buming68/sigamp/README.md

# sigamp
 small RF signal process
 main branch 版本Ver1.0X     无场强LED显示功能，有usart1串口调试功能
 branch-2LED-off  版本1.0B   有场强LED显示功能，双LED兼容输出，其中一个输出用到串口1引脚，所以无usart1串口调试功能
