buming68/sigamp/DOCUMENT/自研移动电视覆盖补点DTV选频处理板测试   2023-04-19.pdf

自研移动电视覆盖补点 DTV 选频处理板测试

### 陆建华 2023-04-19 一、 SDK2712 编调一体机信号源测试

### 1、最小接收门限： -65.7dBm

E8000 频谱仪测试数据 | DS7000 测试数据

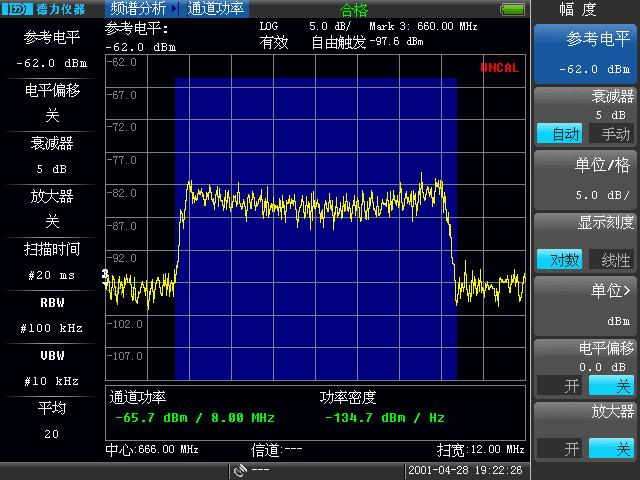
[picture p1: figure]
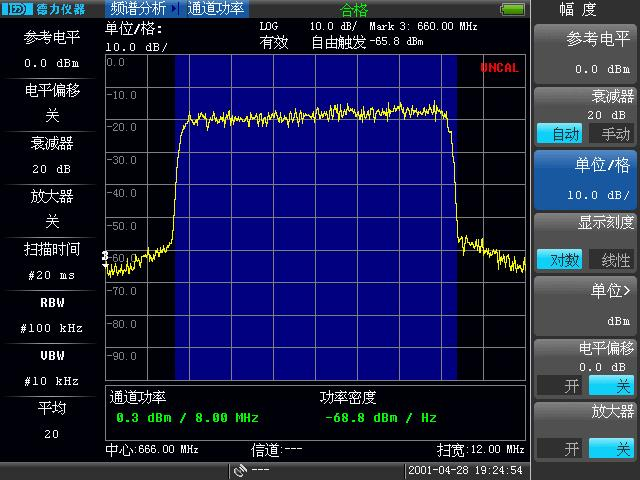
[picture p2: figure]

2、选频处理板输出：0.3dBm

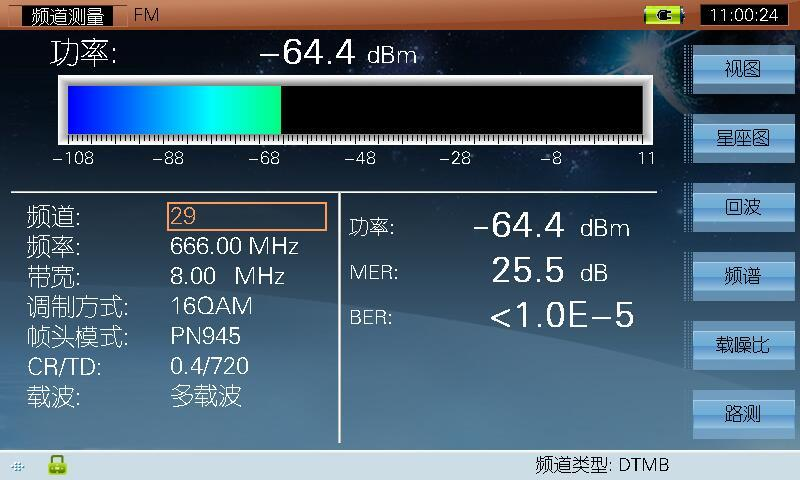
[picture p3: figure]
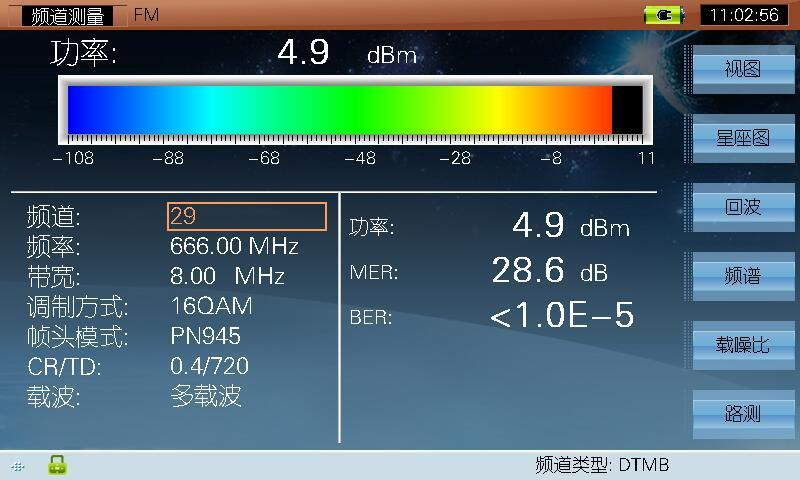
[picture p4: figure]

E8000 频谱仪测试数据 | DS7000 测试数据
| 输入不加衰减器测试

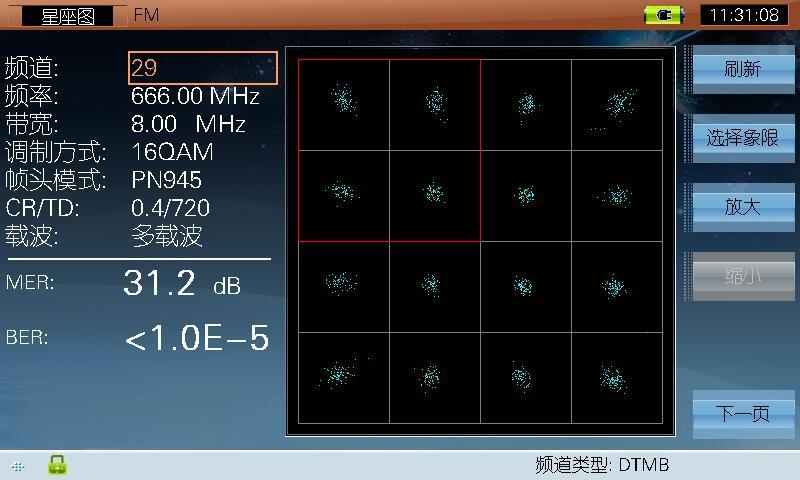
[picture p5: figure]
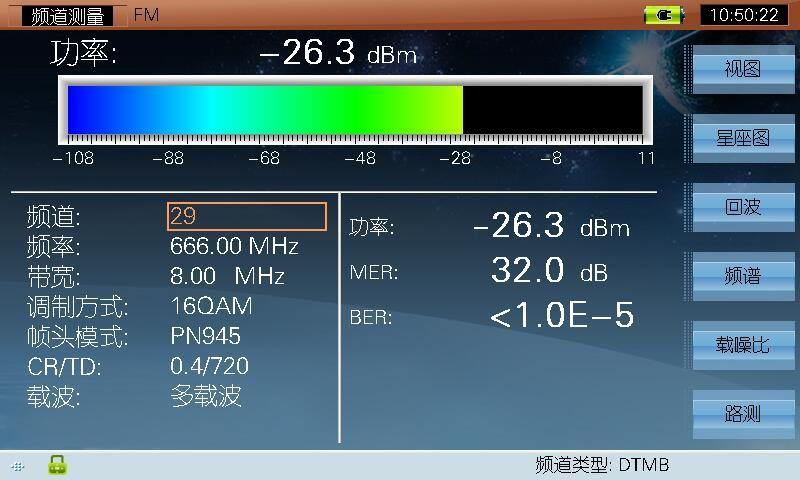
[picture p6: figure]

DS7000 测试的输出信号星族图 | 输入加 30dB 衰减器测试

二、 DS32 频道空收信号测试

1、广电传媒大厦室内接收： -65.7dBm

E8000 频谱仪测试数据 | DS7000 测试数据

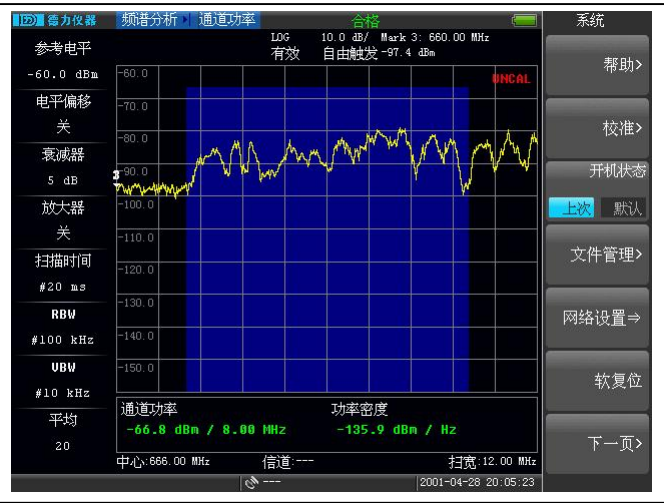
[picture p7: figure]
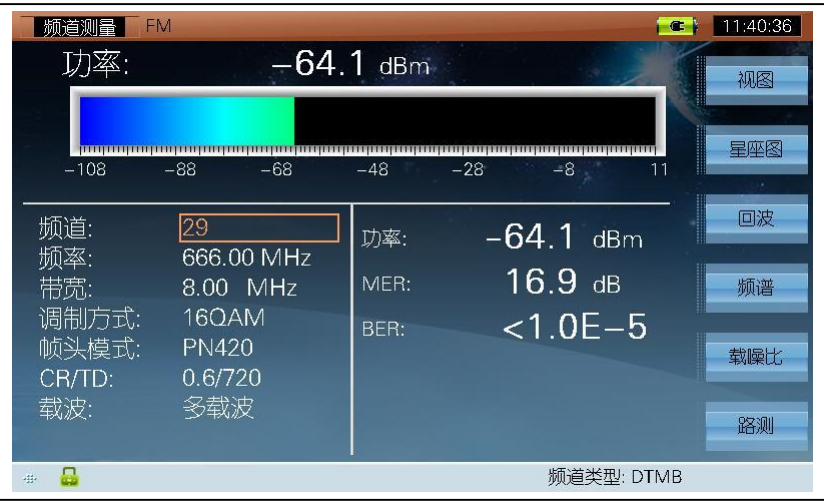
[picture p8: figure]

2、选频处理板输出：-0.1dBm

E8000 频谱仪测试数据 | DS7000 测试数据
| 输入不加衰减器测试

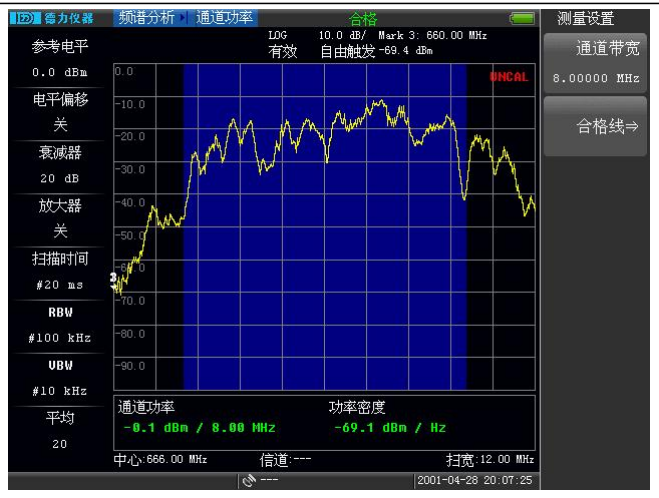
[picture p9: figure]
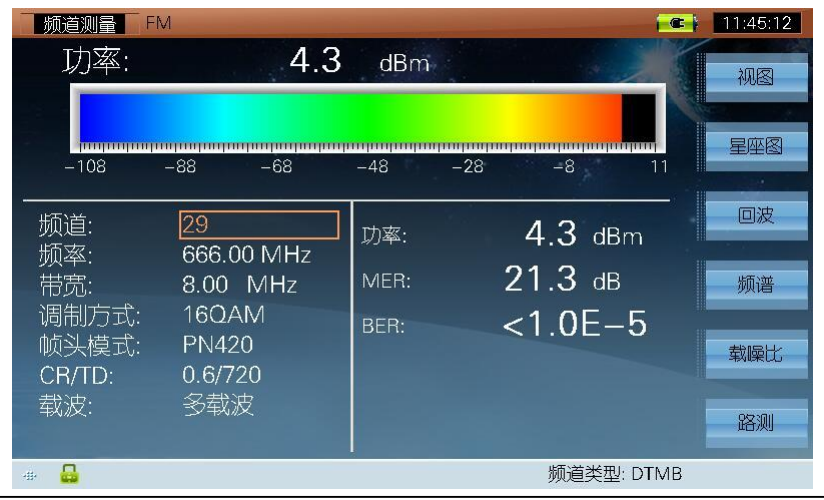
[picture p10: figure]

DS7000 解调图像 | 输入加 30dB 衰减器测试

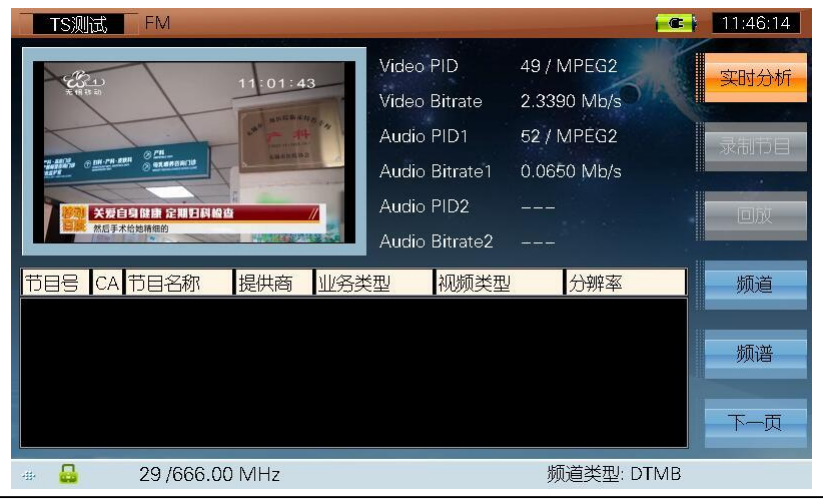
[picture p11: figure]
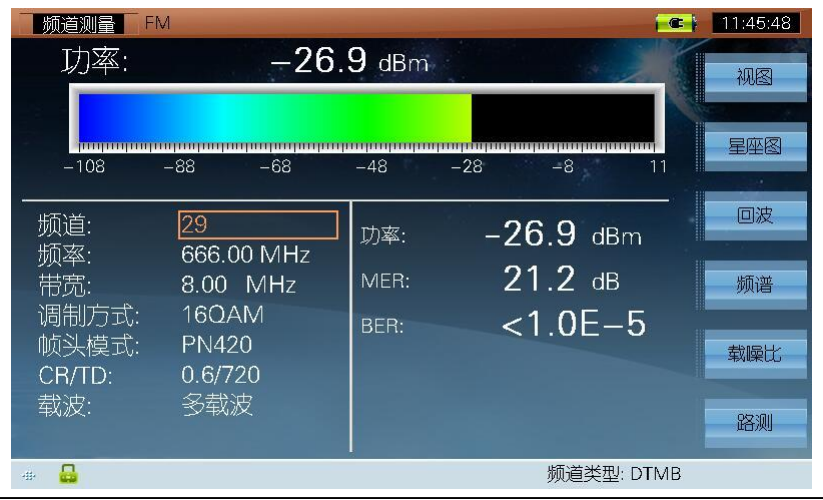
[picture p12: figure]

自研 DTV 选频处理板接收门限设计为-65dBm，原三维产品为

-44dBm，接收门限改善了 20dB 以上。

### —End—
