buming68/sigamp/DOCUMENT/自研DTV小信号选频单元原理图 终稿 2023-04-28.pdf

BOOT1=X | BOOT0=0 主闪存储器启动
BOOT1=0 | BOOT0=1 系统存储器启动

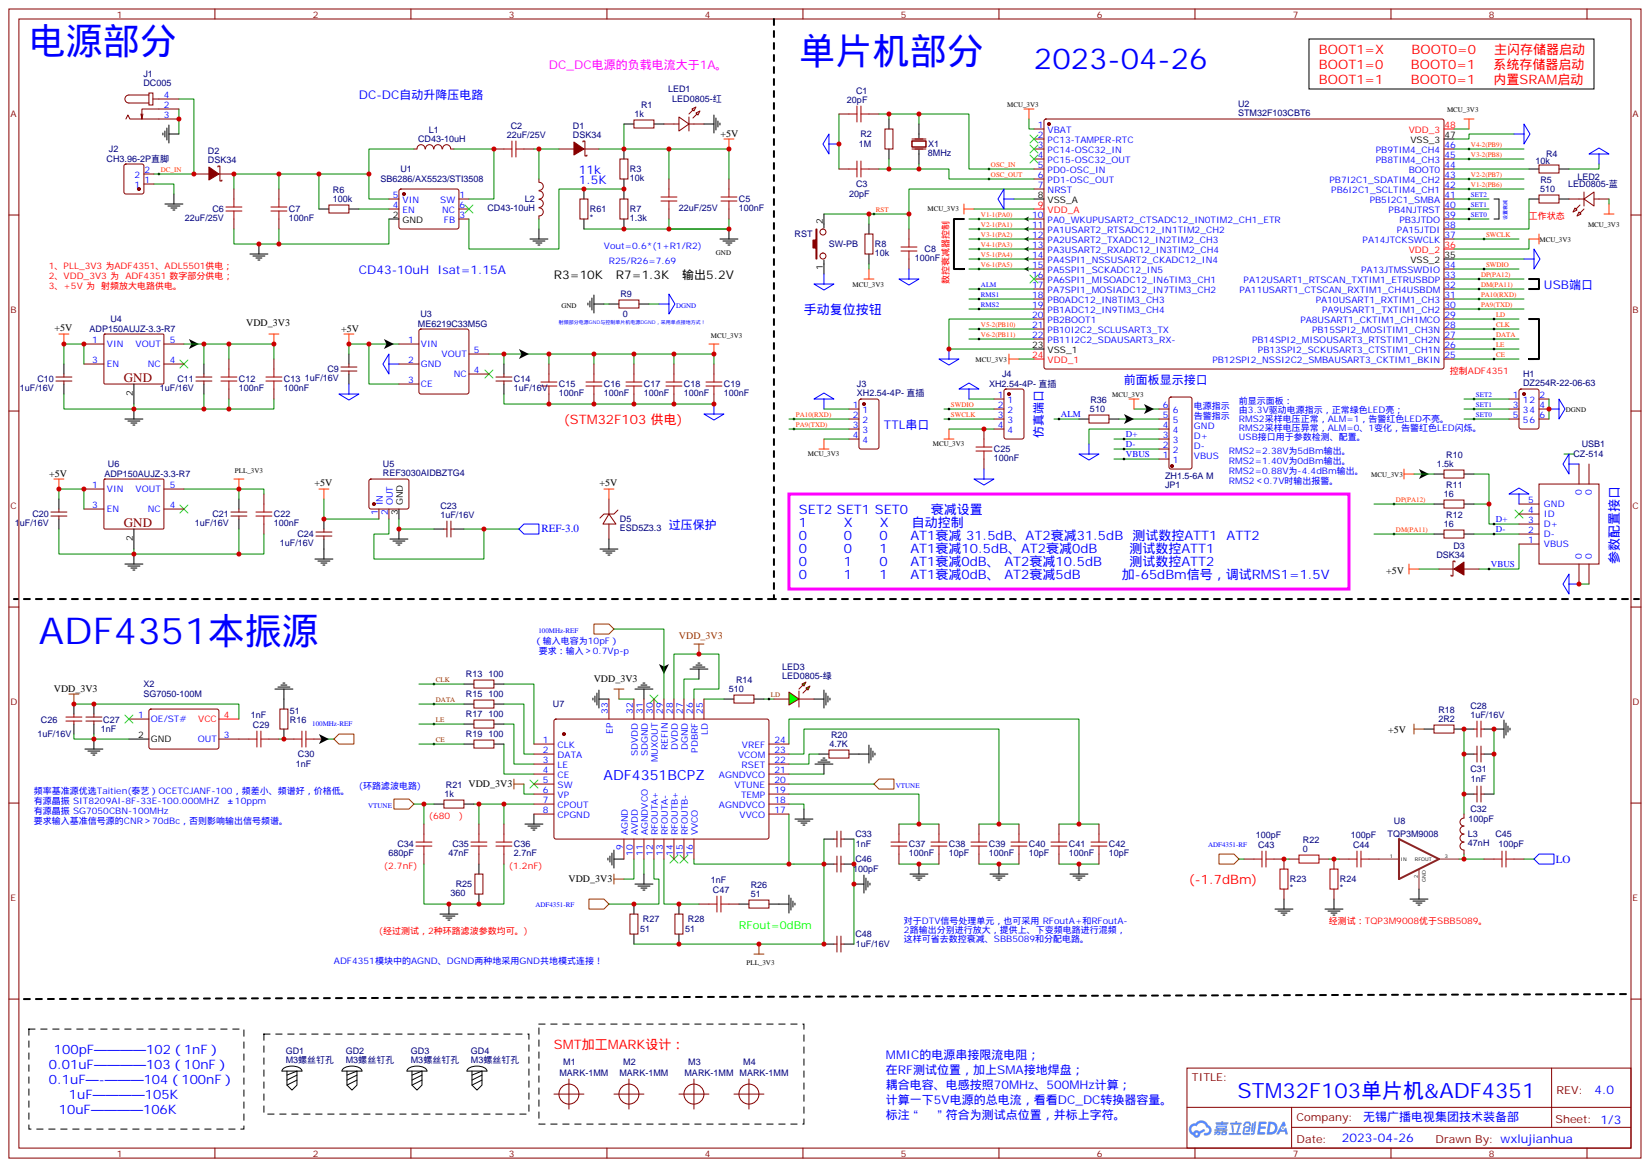
[picture p13: page 1]

LD 25 PDBRF 26 DGND 27 DVDD 28 REFIN 29 MUXOUT 30 SDGND 31 SDVDD 32

VVCO 17 AGNDVCO 18 TEMP 19 VTUNE 20 AGNDVCO 21 RSET 22 VCOM 23 VREF 24

频率基准源优选Taitien(泰艺）OCETCJANF-100，频差小、频谱好，价格低。
有源晶振 SG7050CBN-100MHz
要求输入基准信号源的CNR＞70dBc，否则影响输出信号频谱。

对于DTV信号处理单元，也可采用 RFoutA+和RFoutA-
2路输出分别进行放大，提供上、下变频电路进行混频，
这样可省去数控衰减、SBB5089和分配电路。

# DTV小信号选频单元电路原理图【ok】

## RF 666MHz

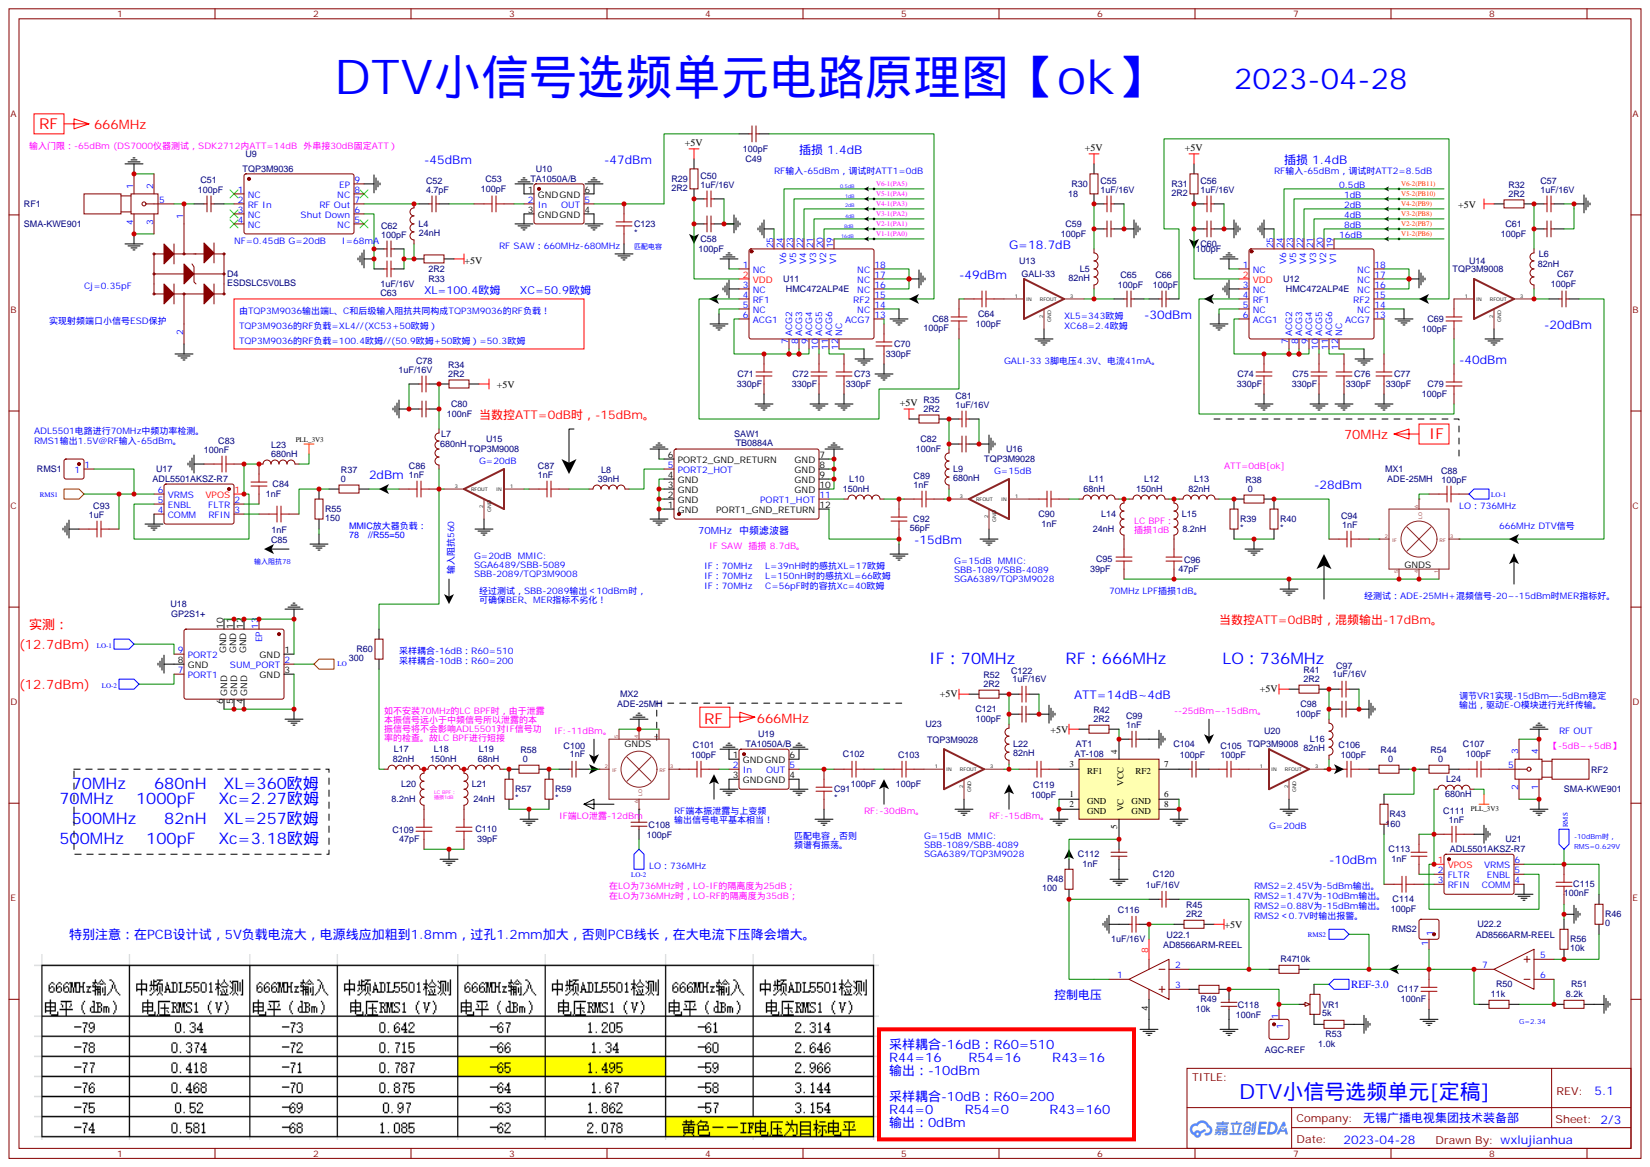
[picture p14: page 2]

ACG7 13 NC 14 RF2 15 NC 16 NC 17 NC 18

特别注意：在PCB设计试，5V负载电流大，电源线应加粗到1.8mm，过孔1.2mm加大，否则PCB线长，在大电流下压降会增大。

# DTV选频处理单元IF功率检测、数控衰减量配置

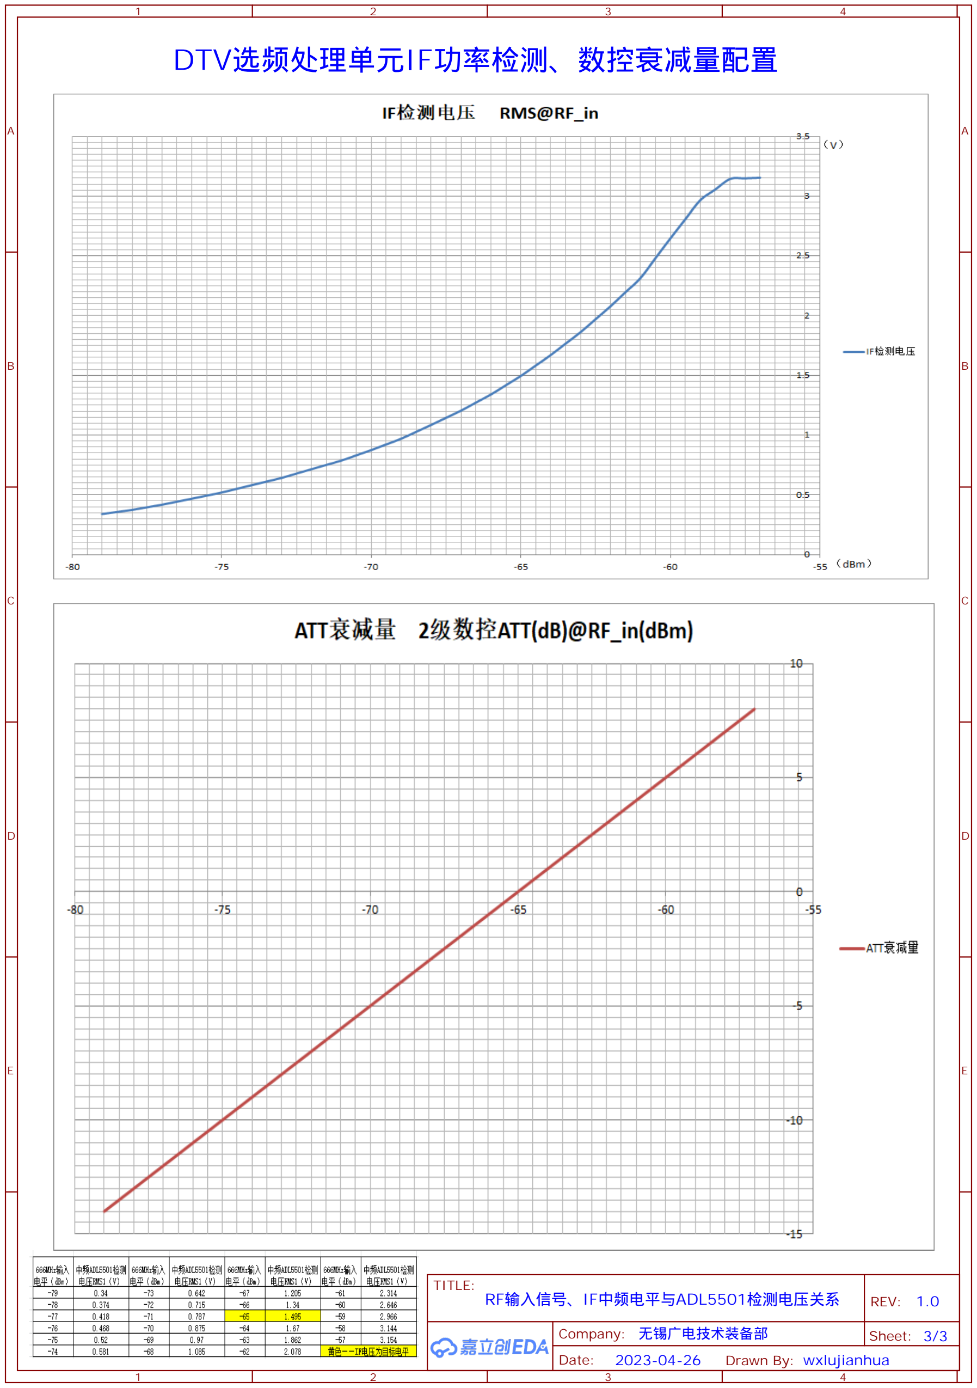
[picture p15: page 3]

A | A
B | B
C | C
D | D
E | E
RF输入信号、IF中频电平与ADL5501检测电压关系 | REV: 1.0

Company: 无锡广电技术装备部
