buming68/sigamp/Core/Inc/main.h

#define LED1_Pin GPIO_PIN_13
#define LED1_GPIO_Port GPIOC
#define HMC0_Pin GPIO_PIN_0
#define HMC0_GPIO_Port GPIOA
#define HMC1_Pin GPIO_PIN_1
#define HMC1_GPIO_Port GPIOA
#define HMC2_Pin GPIO_PIN_2
#define HMC2_GPIO_Port GPIOA
#define HMC3_Pin GPIO_PIN_3
#define HMC3_GPIO_Port GPIOA
#define HMC4_Pin GPIO_PIN_4
#define HMC4_GPIO_Port GPIOA
#define HMC5_Pin GPIO_PIN_5
#define HMC5_GPIO_Port GPIOA
#define LED_SIGNAL_Pin GPIO_PIN_7
#define LED_SIGNAL_GPIO_Port GPIOA
#define HMCB4_Pin GPIO_PIN_10
#define HMCB4_GPIO_Port GPIOB
#define HMCB5_Pin GPIO_PIN_11
#define HMCB5_GPIO_Port GPIOB
#define LED_Pin GPIO_PIN_15
#define LED_GPIO_Port GPIOA
#define SET0_Pin GPIO_PIN_3
#define SET0_GPIO_Port GPIOB
#define SET1_Pin GPIO_PIN_4
#define SET1_GPIO_Port GPIOB
#define SET2_Pin GPIO_PIN_5
#define SET2_GPIO_Port GPIOB
#define HMCB0_Pin GPIO_PIN_6
#define HMCB0_GPIO_Port GPIOB
#define HMCB1_Pin GPIO_PIN_7
#define HMCB1_GPIO_Port GPIOB
#define HMCB2_Pin GPIO_PIN_8
#define HMCB2_GPIO_Port GPIOB
#define HMCB3_Pin GPIO_PIN_9
#define HMCB3_GPIO_Port GPIOB
